djpetti/grobot/schematics/GroBot.pdf

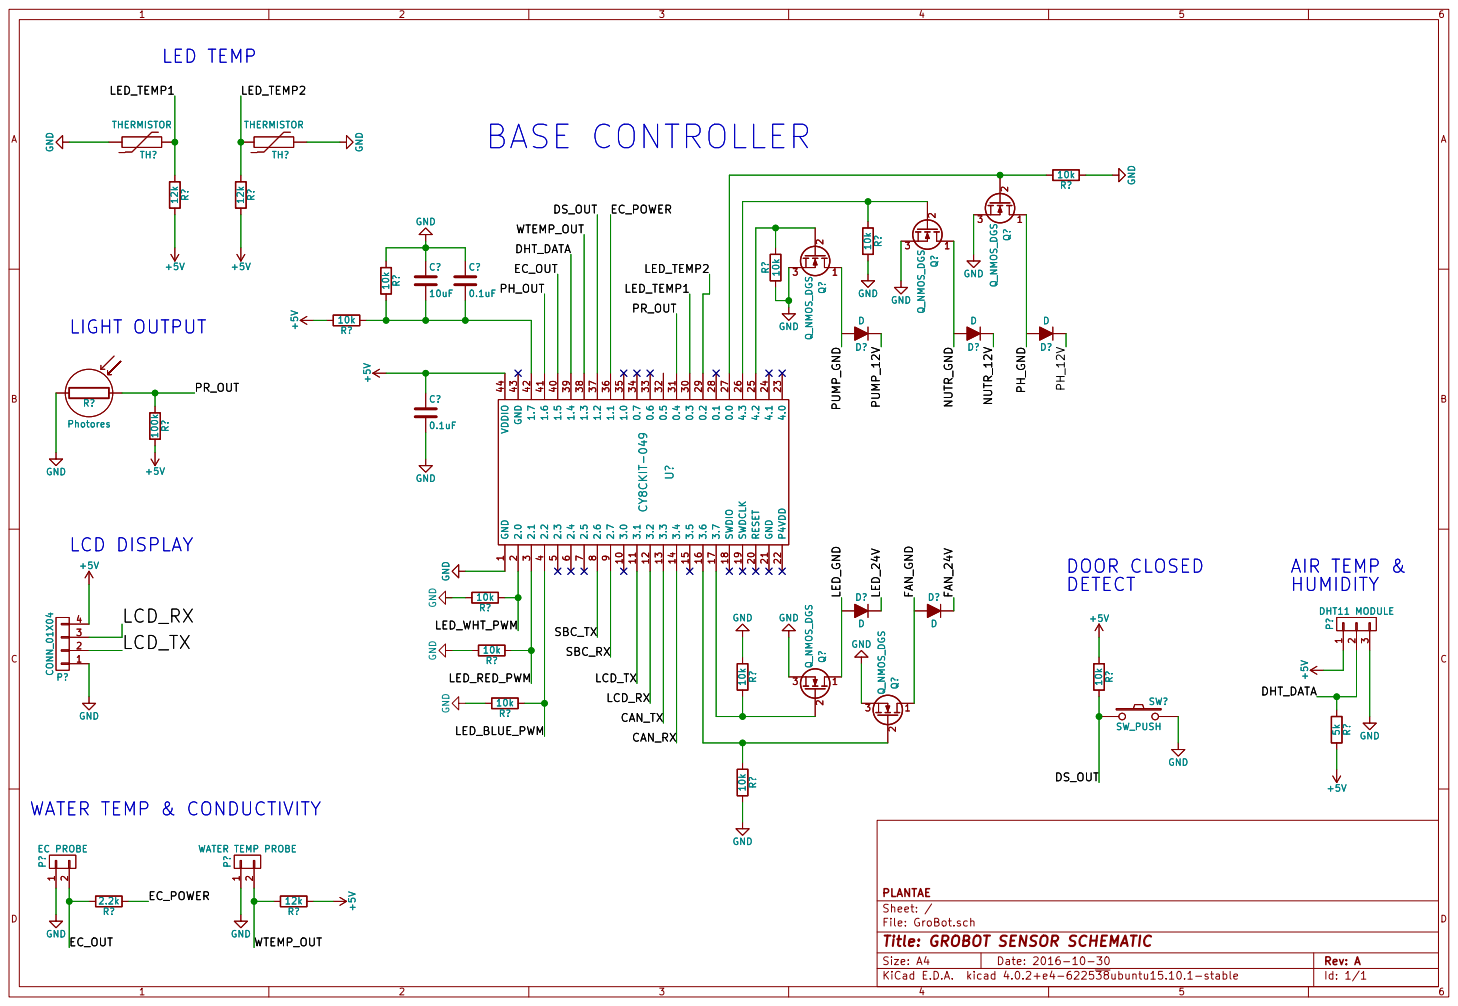
[picture p1: page 1]

9 3.0 10 RESET 20 0.3 30 1.5 40 3.1 11 GND 21 0.4 31 1.6 41 3.2 12 P4VDD 22 0.5 32 1.7 42 3.3 13 4.0 23 0.6 33 GND 43 3.4 14 4.1 24 0.7 34 VDDIO 44 3.5 15 4.2 25 1.0 35 3.6 16 4.3 26 1.1 36 3.7 17 0.0 27 1.2 37 SWDIO 18 0.1 28 1.3 38 SWDCLK 19 0.2 29 1.4 39 U? CY8CKIT-049

File: GroBot.sch Sheet: / PLANTAE GND

2 P? WATER TEMP PROBE GND

Id: 1/1 Title: GROBOT SENSOR SCHEMATIC
