djpetti/grobot/schematics/GroBot.kicad_pcb

## KiCad design electrical_schematic/kicadFiles/schematic.sch

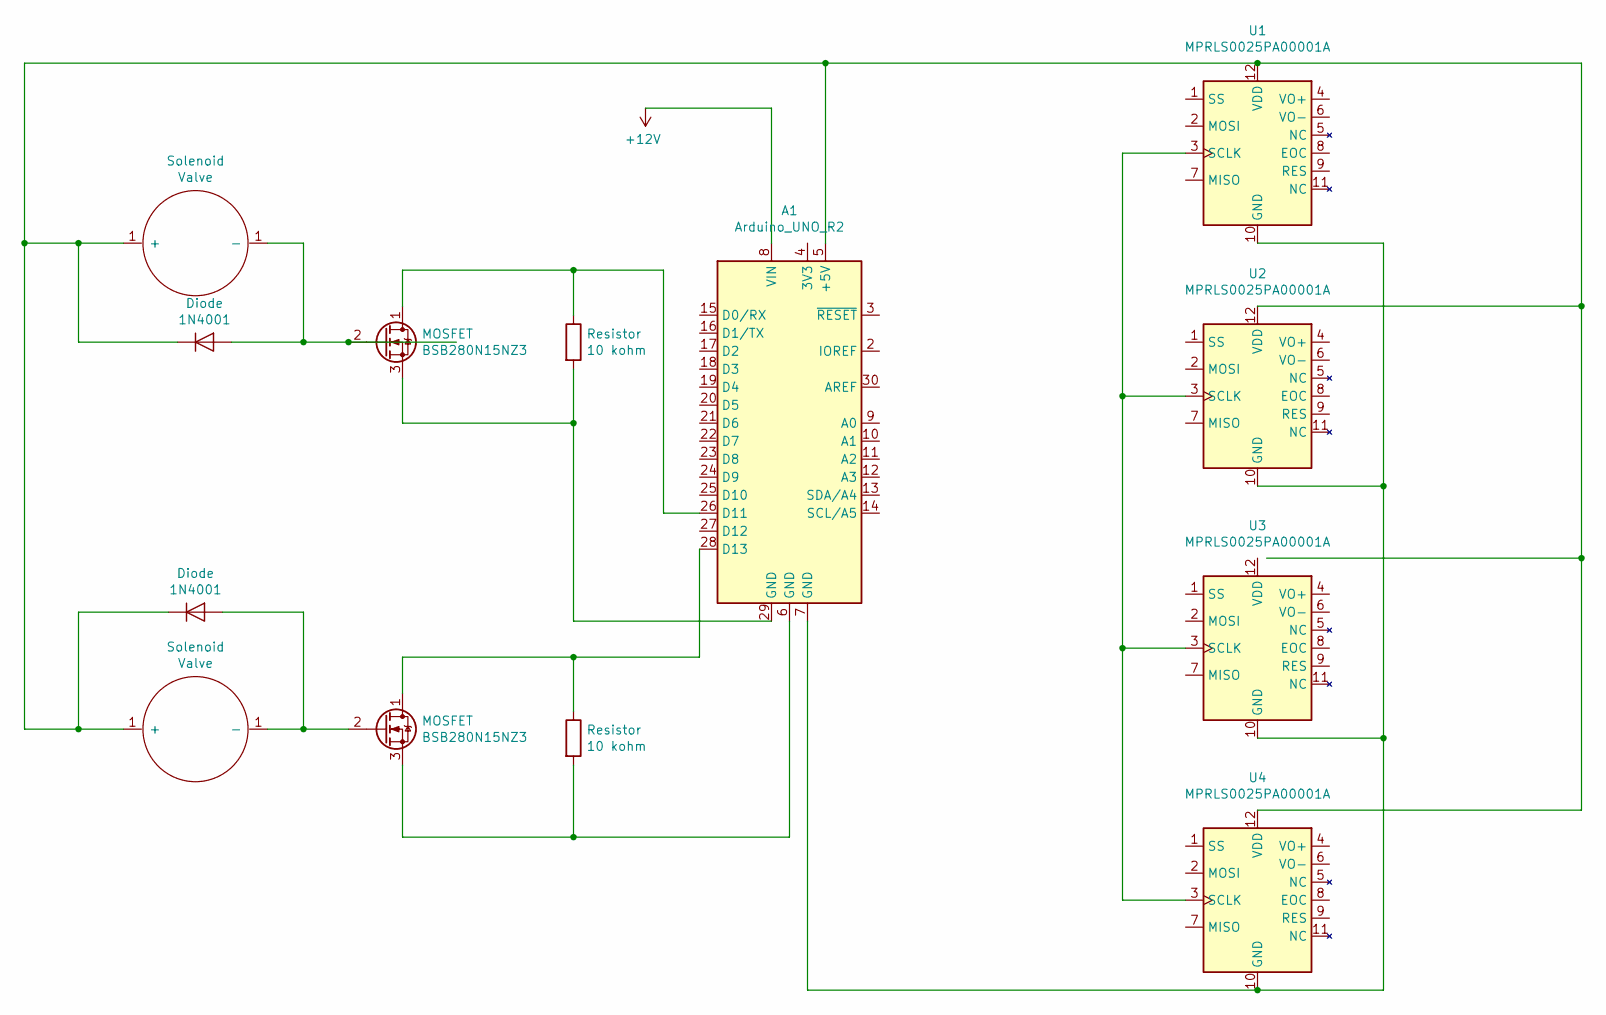
[picture p2: schematic schematic.sch]

Parts:
A1: Arduino_UNO_R2
Diode: 1N4001; D_DO-41_SOD81_P10.16mm_Horizontal
MOSFET: BSB280N15NZ3; DirectFET_MZ
Resistor: 10 kohm
Solenoid: Valve
U1, U2, U3, U4: MPRLS0025PA00001A

Connections:
+12V: A1.8 (VIN)
unnamed: A1.5 (+5V), Diode.1 (K), Solenoid.1, U1.12 (VDD), U2.12 (VDD), U4.12 (VDD)
unnamed: A1.6 (GND), MOSFET.3 (S), Resistor.2
unnamed: A1.7 (GND), U1.10 (GND), U2.10 (GND), U3.10 (GND), U4.10 (GND)
unnamed: A1.26 (D11), MOSFET.1 (D), Resistor.1
unnamed: A1.28 (D13), MOSFET.1 (D), Resistor.1
unnamed: A1.29 (GND), MOSFET.3 (S), Resistor.2
unnamed: Diode.2 (A), MOSFET.2 (G), Solenoid.1
unnamed: U1.3 (SCLK), U2.3 (SCLK), U3.3 (SCLK), U4.3 (SCLK)
