djpetti/grobot/(threads)

Thread 2 (2017-01-29):

Make water temp and EC sensor work.

djpetti, 2017-01-29:
We just need to write some code for this. To my knowledge, there's nothing physically wrong with the hardware. Both of the sensors are resistive, so this shouldn't be all too difficult.

Closed 2017-05-09.

Thread 4 (2017-01-31):

Schematic should match the actual hardware...

djpetti, 2017-01-31:
There is currently some discrepancy between the schematic and how everything is actually connected. We should probably fix that before moving on.

djpetti, 2017-03-06:
This is fixed at this point.

Closed 2017-03-06.

Thread 7 (2017-02-01):

Get PH Sensor Working

djpetti, 2017-02-01:
This is probably one of the more difficult sensors, but it has to be done eventually.

djpetti, 2017-05-14:
Note that this is now lower priority, as the current hardware probably won't support the pH sensor correctly.

Thread 10 (2017-02-07):

Fix hardware problems discovered during testing.

djpetti, 2017-02-07:
Here are some issues that I have discovered with the hardware design over the course of testing the system:

- The resistor for the water temp should not be 12k. 12k is optimal if you want to read in a 25 to 80C temperature range. For the water temp, we want a range of more like 0C to 65C. We should figure out the correct resistor for this and fix it.
- We need a way to put the PSoC into bootloader mode without having to physically press the button.

Closed 2017-05-09.

Thread 11 (2017-02-07):

Substitute STM chip for dev board.

djpetti, 2017-02-07:
This should be changed in the schematic. We should select a chip that is similar to what is on the dev board.

djpetti, 2017-04-10:
We're probably going to do the initial board design with an STM chip, actually.

Closed 2017-05-09.

Thread 34 (2017-07-27):

Fix Deprecation Warning

djpetti, 2017-07-27:
When you run the unit tests currently, you get a message like this from Polymer WCT:

```warn: [polymer-project-config]    "includeDependencies" config option has been renamed to "extraDependencies" and will no longer be supported in future versions```

This should be fixed.

Closed 2017-07-27.

Thread 36 (2017-07-28):

Remove side-effects from Redux actions.

djpetti, 2017-07-28:
Currently, there are certain Redux actions that have side-effects other than updating the state. This makes testing difficult and debugging annoying. I will be removing them through the use of [redux-saga](https://github.com/redux-saga/redux-saga).

Closed 2017-09-05.

Thread 37 (2017-07-28):

Add support for persistent JS tests from deploy.py.

djpetti, 2017-07-28:
The persistent testing option is useful when trying to debug failing tests. However, to use it, you currently have to run `polymer test -p` manually. It would be nice if there was an option for this from `deploy.py`.

Closed 2017-07-28.

Thread 46 (2017-09-05):

Test Inter-Module Communication

djpetti, 2017-09-05:
The modules are supposed to communicate via an I2C system which is fairly intricate, but has never been fully tested due to lack of hardware. Testing, however, would be fairly simple, one would need merely to buy two PSoC dev boards and wire them together properly. Aside from basic testing, the module discovery process should be specifically verified.

Thread 47 (2017-09-05):

Base Module Hardware Layout

djpetti, 2017-09-05:
I've (mostly) finished the schematics for the new base module hardware, however, these need to be verified, and the circuit board layout needs to be done.

[This](https://github.com/djpetti/grobot/wiki/Hardware) is a useful Wiki page for anyone interested.

Thread 48 (2017-09-05):

Grow Module Hardware Design

djpetti, 2017-09-05:
The schematics for the grow module controller haven't even been started yet. That can be done as well.

[This](https://github.com/djpetti/grobot/wiki/Hardware) is a useful Wiki page for anyone interested. Right now it's more focused on the Base Module design, but some stuff is still relevant.

djpetti, 2017-10-03:
Just wanted to add more exact requirements for this project:

The grow module boards are less complicated than the base module. Grow modules, however, do use the same MCUs as the base module.

Apart from the MCU, the grow module board should contain the following hardware:
- 3 1A current-controlled channels for driving LEDs. Currently, we are using [these](http://store3.sure-electronics.com/le-ll51111) discrete driver boards, but in this design, they should be integrated directly onto the PCB. The drivers should tolerate up to a 24V input voltage. The drivers must also support dimming from the MCU, preferably via a PWM signal. It is up to you to select which specific chip you want to use.
- A MOSFET with an associated connector that can be used to drive an LED cooling fan with a PWM output from the MCU. The fan that we are using runs at 24V, and draws 140 mA.
- Inputs for a simple photoresistor sensor, as well as three thermistor temperature sensors for the LEDs. These can be fed directly into analog inputs on the MCU. The current schematics in the master branch should contain descriptions of the equivalent circuits as used on the current prototype, including an indication of what resistor values work best for the voltage dividers. [Here](https://www.digikey.com/product-detail/en/vishay-bc-components/NTCLE100E3103JB0/BC2301-ND/769411) is a link to the thermistors we are using on Digikey.
- CAN bus signals that will be fed to adjoining modules. The [hardware](https://github.com/djpetti/grobot/wiki/Hardware) page on the wiki has a link to the particular CAN transceiver chip that I spec'd for the base module board, so I would strongly recommend that you use the same one.
- The only power input this board will be getting is a line straight from the 24V supply. That means that you will be responsible for producing any other voltages you need. Again, this is a problem I've already solved in my design for the base module board. The relevant part numbers for the regulators are listed on the hardware Wiki page. It would be nice if you could use the same ones, but you might have to spec different ones due to different current requirements on this board. (For instance, you don't have the CHIP SBC sucking down 1A from your 5V supply like we do on the base board.)

Thread 56 (2017-09-15):

POST Tests for the MCUs

djpetti, 2017-09-15:
This is a pretty easy task.

It would be nice to have a basic POST sequence for the MCUs. This might include, but is not limited to:

- Checking temperature sensors for reasonable values.
- Checking air temperature and humidity for reasonable values.
- Checking water temperature for reasonable values.
- Checking water EC and pH for reasonable values (assuming there is water.)

Assuming the POST sequence fails, probably the best course of action to take is to notify Prime. You can create a special message type for this.

Thread 57 (2017-09-15):

Calibrating EC Sensor

djpetti, 2017-09-15:
This also shouldn't be too hard, and I have done some of the work.

A simple EC sensor can be recreated using a power plug and a few resistors. The prongs of the plug are immersed in the solution, and act as one side of a voltage divider. Then the MCU does some math to convert the read voltage into an EC estimate.

For calibration, a set of ionic solutions of known concentration should be used. I have used NaCl in the past, which works well, and is easy to make. The probe can be connected to an MCU dev board, inserted into the solutions, and the raw values from the ADC can be read and measured. Then, we can do some math to find the best values for the calibration constants.

The code for reading EC values already exists, so not much coding is involved in this task. However, the tester must understand how the existing code works. This, therefore, would make a good starting project for someone who wishes to gain familiarity with the MCU source code.
