djpetti/grobot/(commit log)

2017-01-31 Add KiCad project.
    This is the old schematic from IED.
    [GroBot.kicad_pcb, GroBot.sch]
2017-01-31 Add custom PSoC KiCad library.
    Also name stuff a little better.
    [GroBot.kicad_pcb, GroBot.sch]
2017-02-07 Added I2C labels, fixed duplicate components fixes #4
    [GroBot.sch]
2017-02-07 Fixed some connectivity problems, added missing junctions
    [GroBot.sch]
